TimTini/thung-rac-4-goc/fusion/ThungRac4Goc/README.md

# Chạy ThungRac4Goc

Thư mục này là bộ script để thêm vào Fusion. Hướng dẫn đầy đủ, tham số, giới hạn và kiểm chứng nằm tại [../README.md](../README.md).
