TimTini/thung-rac-4-goc/docs/REFERENCES.md

# Tài liệu thiết kế dùng lại

## Stratasys FDM Design Guide (2025)

- [PDF chính thức](https://www.stratasys.com/siteassets/sdm/content---website-storage/design-guides/dg_sdm_fdm_0725a.pdf).
- Tên bản PDF trong thư viện offline: `stratasys-fdm-design-guide-2025.pdf`.
- Tên ghi chú điều hướng offline: `stratasys-fdm-design-guide-2025.md`.
- Đã tải và xác minh ngày 2026-10-13: 10 trang, 893.057 byte.
- SHA-256: `4c92aa8d7d3f51383bd8d8d5ac6aa5463b5aa7eb6ed59663073eefa85b96a495`.

PDF của hãng được giữ trong thư viện local chung, ngoài repository này. Khi cần
tra gân, gusset hoặc fillet, xem trang PDF 7; khi tra hướng in, chia part hoặc khe
hở lắp, xem trang PDF 8. Số trang tính từ bìa PDF, khác số in cuối trang.

Đây là tài liệu tham khảo FDM Stratasys, không phải chứng nhận cho model này.
Các khóa đáy V5/V6 là hình học tự triển khai; tài liệu hãng không xác nhận lực
lắp, độ bền ngàm, tải trọng hoặc vật liệu/hướng in của chúng. Dùng coupon và
kiểm chứng phù hợp trước khi in cả cụm. Không lấy quy tắc ép phun áp nguyên sang FDM.
