TimTini/thung-rac-4-goc/docs/STRUCTURE.md

# Cấu trúc dự án thung-rac-4-goc

Điểm bắt đầu: [README](../README.md). Source chính và script chạy giữ ở thư mục gốc. Chuẩn thư mục áp dụng ngày 26/10/2026.

## File và thư mục hiện có

Source: `thung-rac-4-goc.scad; thung-rac-4-goc-v2.scad đến -v8.scad`.

- [exports/](../exports/): đầu ra CAD, preview và report theo pipeline.
- [docs/](../docs/): tài liệu project và ảnh minh họa.
- [fusion/](../fusion/): script/manifest, hướng dẫn và test Fusion.
- [tests/](../tests/): kiểm thử project.
- `work/` (local): checkpoint và khảo sát local.

Các SCAD, build-vN.py, verify-vN-variants.py và README-vN.md giữ tại gốc; exports/vN giữ đầu ra theo phiên bản. README chính chỉ rõ phiên bản đang dùng.

## Quy ước dùng chung

- `exports/` chứa đầu ra; README/manifest xác định bộ hiện hành và revision nguồn.
- `reference/` chứa input và provenance khi có; `assets/` giữ tài nguyên runtime khi có.
- `docs/` chứa tài liệu, `work/` chứa checkpoint/khảo sát local, `work/tmp/` chứa file thử và `backups/` chứa snapshot khi cần. Thư mục được tạo theo dữ liệu thực tế.
- `archive/` giữ phiên bản lịch sử khi project dùng cơ chế đó. Các thư mục chuyên biệt tiếp tục theo pipeline hiện có.
- Kiểm source/đường dẫn, render, native Fusion, slicer và thử vật lý có trạng thái bằng chứng riêng trong hồ sơ kỹ thuật.

## Tra đường dẫn lịch sử

Các vị trí dữ liệu hiện tại được giữ trong đợt chuẩn hóa này. Report, snapshot và log cũ giữ thông tin tại thời điểm chạy; áp dụng bản đồ trên khi tra locator cũ. Tài liệu và script đang dùng tham chiếu vị trí hiện hành.
