TimTini/thung-rac-4-goc/exports/v8/exploded.png

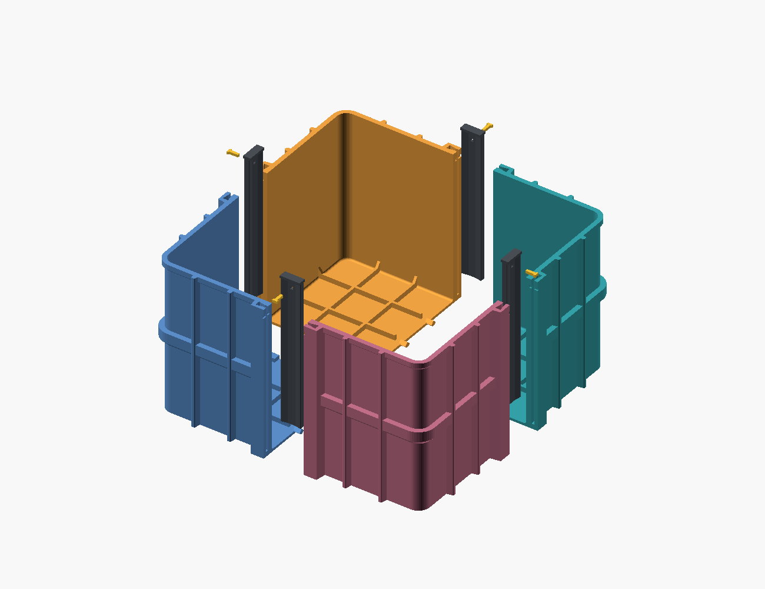
exports/v8/exploded.png
