TimTini/thung-rac-4-goc/exports/v8/audit/corner_0_sweep_x.stl

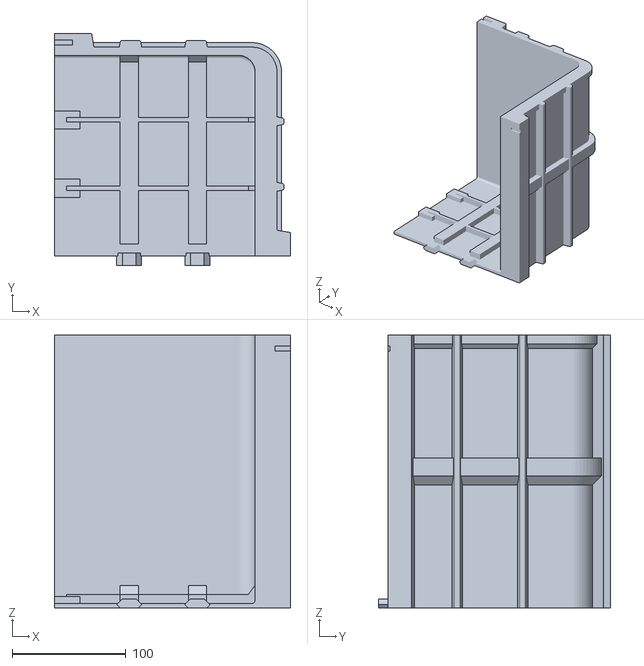
[picture p5: CAD file, 2026-10-13]
exports/v8/audit/corner_0_sweep_x.stl
207.8 x 204.0 x 240.0
