TimTini/thung-rac-4-goc/exports/v8/corner_nw.stl

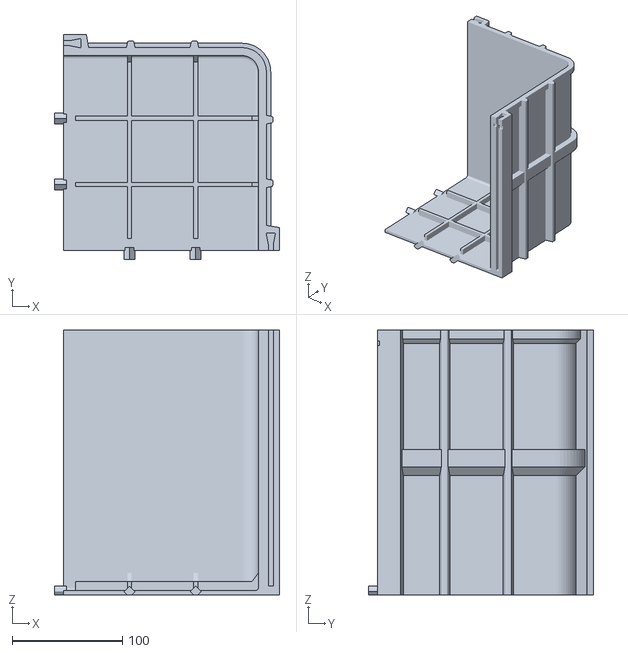
[picture p6: CAD file, 2026-10-13]
exports/v8/corner_nw.stl
204.0 x 204.0 x 240.0
