TimTini/thung-rac-4-goc/exports/v8/audit/corner_1_sweep_y.stl

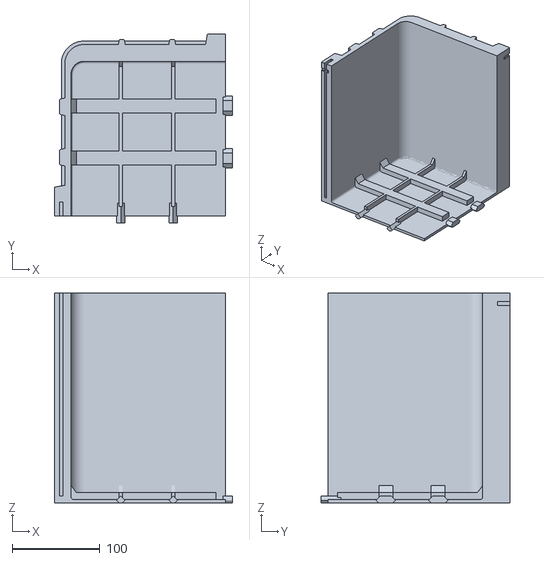
[picture p7: CAD file, 2026-10-13]
exports/v8/audit/corner_1_sweep_y.stl
204.0 x 216.0 x 240.0
