TimTini/thung-rac-4-goc/exports/base.stl

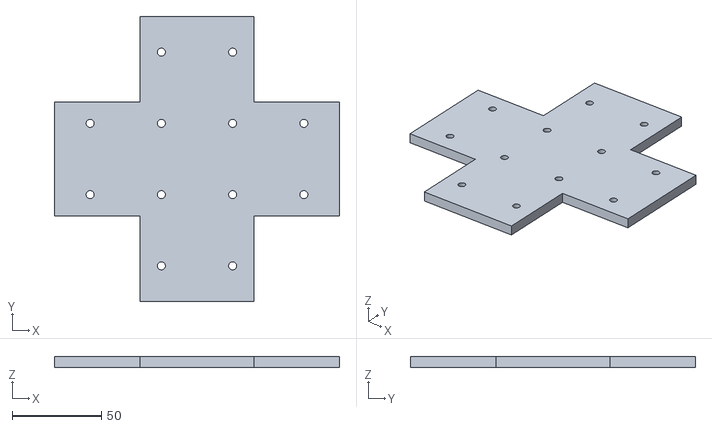
[picture p8: CAD file, 2026-10-12]
exports/base.stl
160.0 x 160.0 x 6.00
