TimTini/thung-rac-4-goc/exports/v8/audit/corner_3_sweep_x.stl

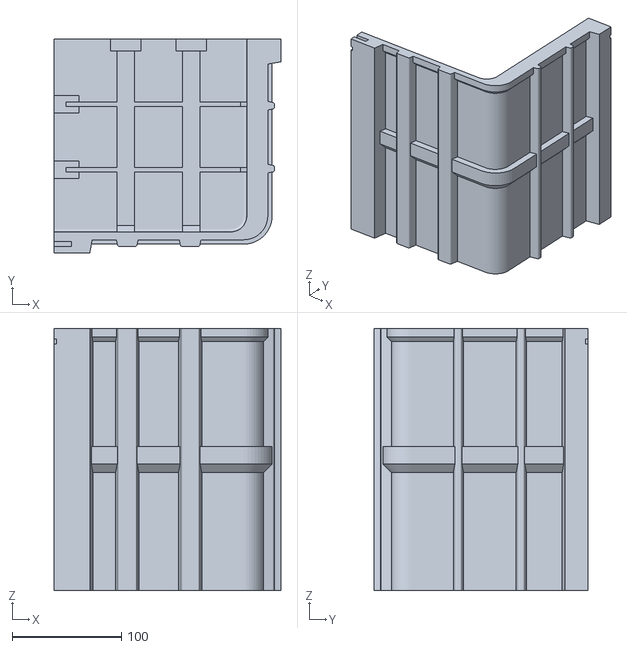
[picture p9: CAD file, 2026-10-13]
exports/v8/audit/corner_3_sweep_x.stl
207.8 x 195.8 x 240.0
