TimTini/thung-rac-4-goc/exports/v8/floor_coupon_male.stl

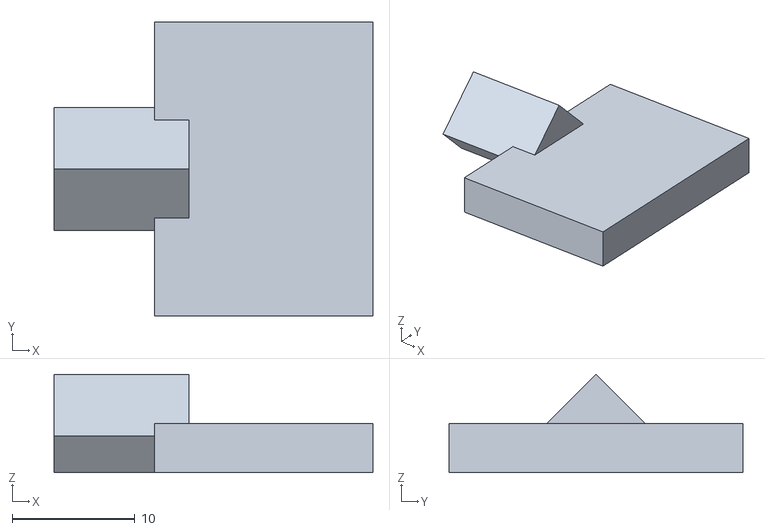
[picture p10: CAD file, 2026-10-13]
exports/v8/floor_coupon_male.stl
26.0 x 24.0 x 8.00
