TimTini/thung-rac-4-goc/exports/v8/floor_coupon_female.stl

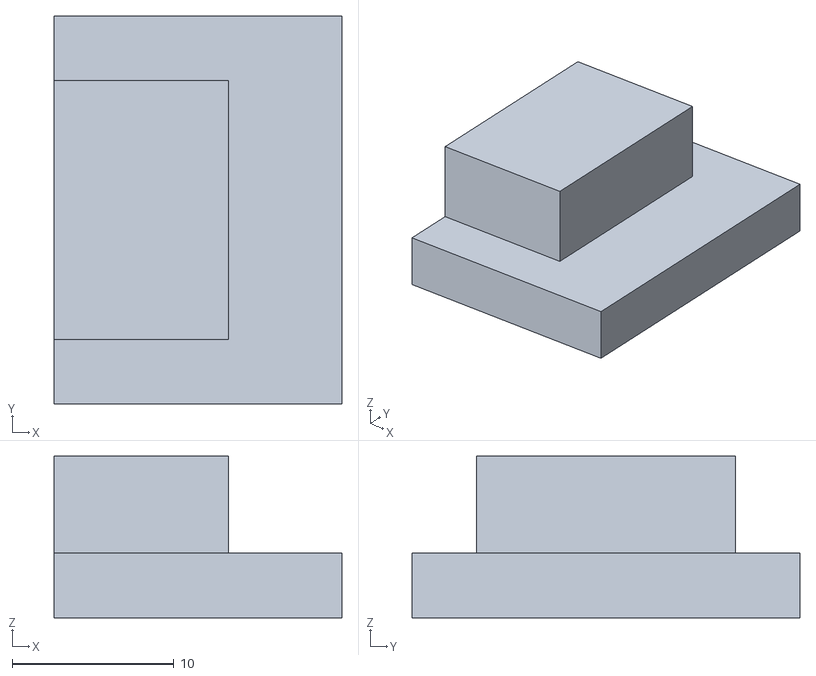
[picture p11: CAD file, 2026-10-13]
exports/v8/floor_coupon_female.stl
17.8 x 24.0 x 10.0
