TimTini/thung-rac-4-goc/exports/v8/floor_coupon.stl

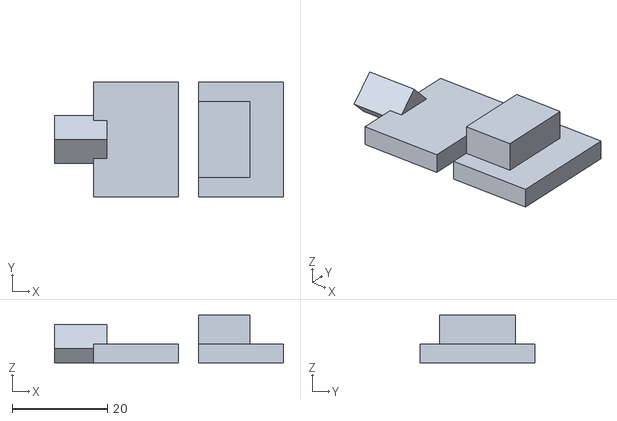
[picture p12: CAD file, 2026-10-13]
exports/v8/floor_coupon.stl
48.0 x 24.0 x 10.0
