TimTini/thung-rac-4-goc/exports/v8/pin.stl

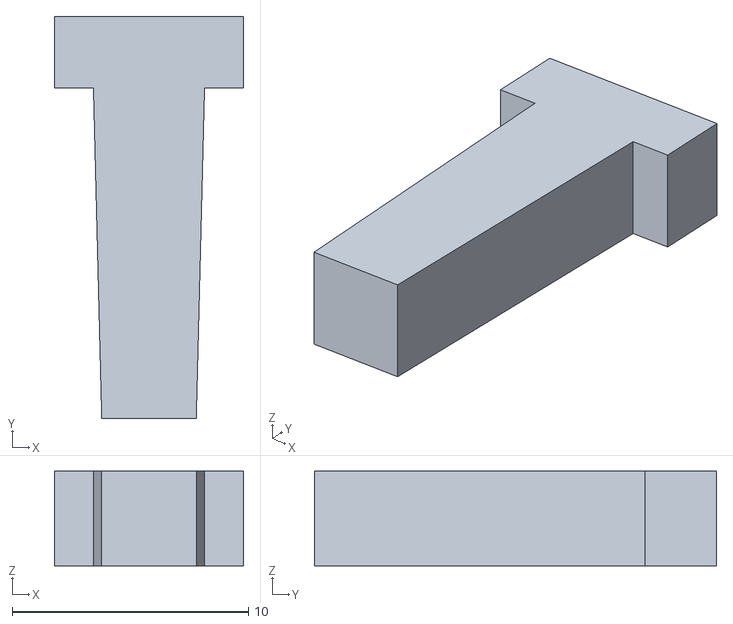
[picture p13: CAD file, 2026-10-12]
exports/v8/pin.stl
8.00 x 17.0 x 4.00
