TimTini/thung-rac-4-goc/exports/v8/key.stl

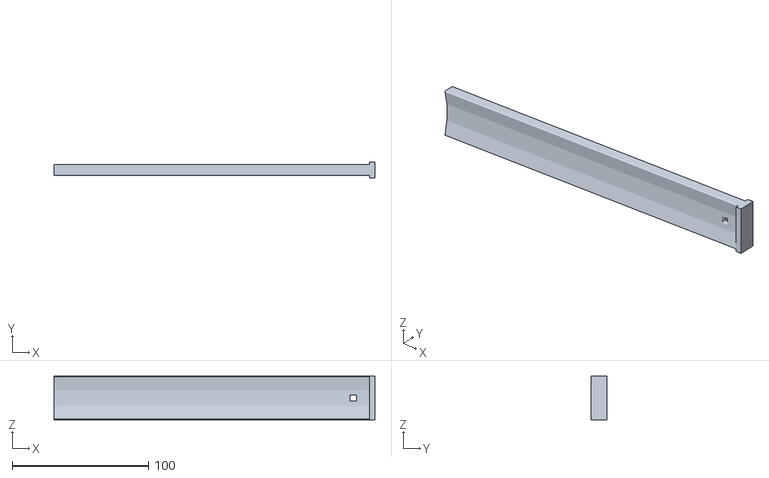
[picture p14: CAD file, 2026-10-12]
exports/v8/key.stl
236.0 x 12.0 x 32.0
