TimTini/thung-rac-4-goc/exports/corner.stl

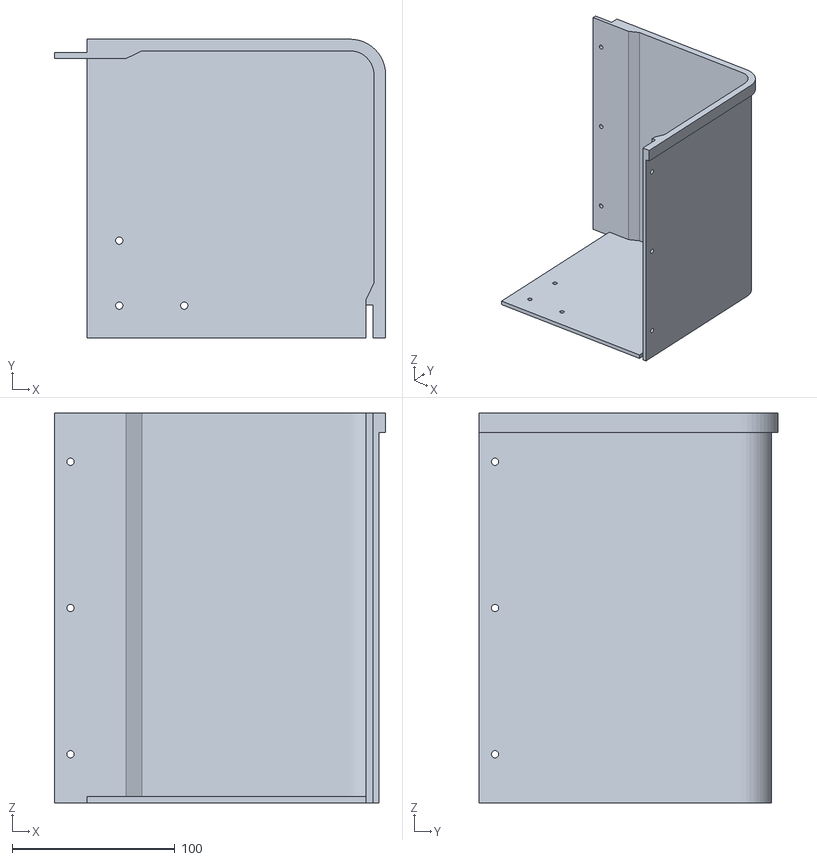
[picture p15: CAD file, 2026-10-12, an earlier design]
exports/corner.stl
204.0 x 183.8 x 240.0
