TimTini/thung-rac-4-goc/exports/v2/bridge.stl

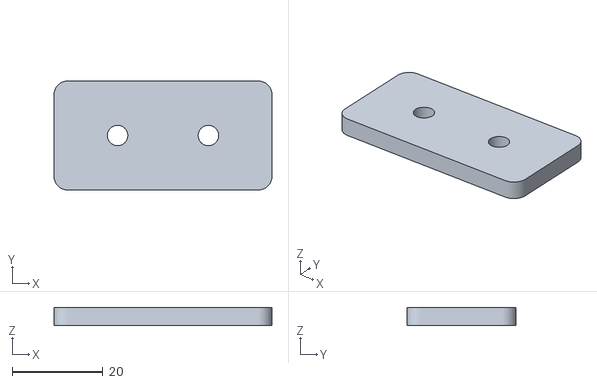
[picture p16: CAD file, 2026-10-12, an earlier design]
exports/v2/bridge.stl
48.0 x 24.0 x 4.00
