TimTini/thung-rac-4-goc/exports/v4/coupon.stl

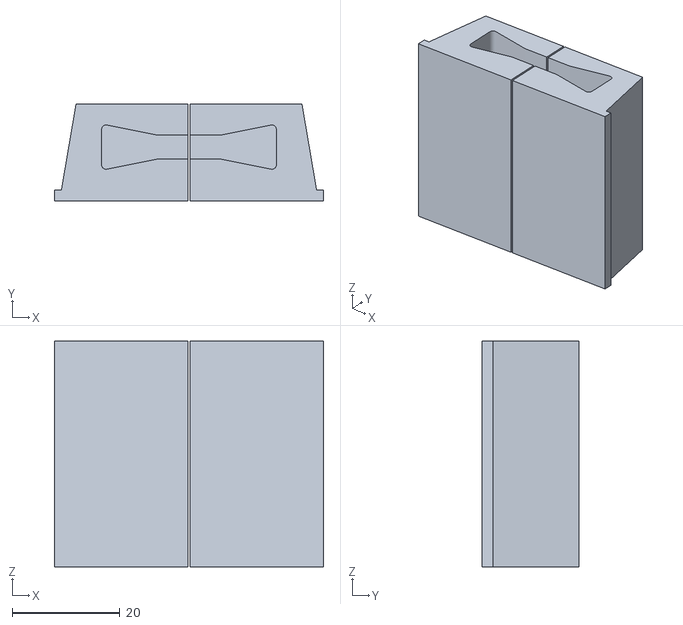
[picture p17: CAD file, 2026-10-12, an earlier design]
exports/v4/coupon.stl
50.0 x 18.0 x 42.0
