TimTini/thung-rac-4-goc/(list of files, cad)

Other CAD files:
exports/v8/corner_ne.stl
exports/v8/audit/corner_0_sweep_y.stl
exports/v8/corner_sw.stl
exports/v8/corner_se.stl
exports/v3/corner.stl
thung-rac-4-goc-v2.scad
thung-rac-4-goc-v3.scad
exports/coupon.stl
exports/v2/corner.stl
exports/v2/coupon.stl
exports/v2/frame.stl
exports/v3/coupon.stl
exports/v3/coupon_key.stl
exports/v3/coupon_pin.stl
exports/v3/key.stl
exports/v3/pin.stl
exports/v4/corner.stl
exports/v5/corner.stl
exports/v5/coupon.stl
exports/v5/floor_coupon.stl
exports/v5/floor_key.stl
exports/v5/floor_key_sweep.stl
exports/v6/audit/floor_clip_loading_sweep.stl
exports/v6/audit/floor_clip_slide_sweep.stl
exports/v6/audit/floor_key_pressed.stl
exports/v6/audit/floor_latch_release_sweep.stl
exports/v6/corner.stl
exports/v6/coupon.stl
exports/v6/coupon_key.stl
exports/v6/floor_coupon.stl
exports/v6/floor_key.stl
exports/v7/audit/floor_key_sweep.stl
exports/v7/audit/floor_pin_sweep.stl
exports/v7/corner.stl
exports/v7/floor_coupon.stl
exports/v7/floor_coupon_key.stl
exports/v7/floor_key.stl
exports/v7/floor_pin.stl
thung-rac-4-goc-v4.scad
thung-rac-4-goc-v5.scad
thung-rac-4-goc-v6.scad
thung-rac-4-goc-v7.scad
thung-rac-4-goc.scad
