TimTini/thung-rac-4-goc/exports/assembled.png

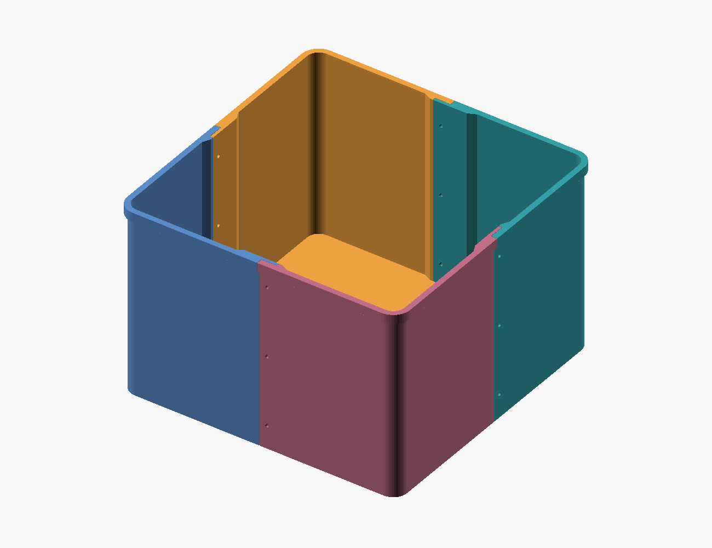
exports/assembled.png
