TimTini/thung-rac-4-goc/(commit log)

2026-10-12 Publish parametric four-corner bin and native Fusion script
    [base.stl, bridge.stl, corner.stl, coupon.stl, coupon_key.stl, coupon_pin.stl, frame.stl, key-bed-250-preview.scad]
2026-10-13 Add V5 floor joint locks and floor-to-wall reinforcement
    [corner.stl, coupon.stl, coupon_key.stl, floor_coupon.stl, floor_key.stl, floor_key_sweep.stl, key.stl, pin.stl]
2026-10-13 Add recessed V6 floor clips with FDM-friendly geometry
    [corner.stl, coupon.stl, coupon_key.stl, floor_clip_loading_sweep.stl, floor_clip_slide_sweep.stl, floor_coupon.stl, floor_key.stl, floor_key_pressed.stl]
2026-10-13 Add low sliding floor rails with FDM-oriented caps and fit audits
    [corner.stl, floor_coupon.stl, floor_coupon_key.stl, floor_key.stl, floor_key_sweep.stl, floor_pin.stl, floor_pin_sweep.stl, key.stl]
2026-10-13 Integrate support-conscious sliding floor rails into four corner parts
    [corner_0_sweep_x.stl, corner_0_sweep_y.stl, corner_1_sweep_y.stl, corner_3_sweep_x.stl, corner_ne.stl, corner_nw.stl, corner_se.stl, corner_sw.stl]
2026-10-14 Point agents to the portable general CAD learning guide
2026-10-15 docs: relocate shared CAD guides outside model projects
